AndreiasM5/IVA_DECK/README.md

<div align="center">

# IVA DECK

### A custom ESP32 macro keyboard with a desktop companion and behavioral recognition

**9 mechanical keys · 3 volume controls · LCD + microSD · USB / Bluetooth · Python + PyQt6**

[Download Windows app](https://github.com/AndreiasM5/IVA_DECK/releases/latest) · [Install V5](docs/windows-app-v5.ro.md) · [Demo](docs/media/iva-deck-demo.mp4) · [Get started](docs/getting-started.md) · [Hardware](docs/hardware.md) · [Protocol](docs/protocol.md) · [AI experiment](docs/behavioral-recognition.md) · [Română](docs/README.ro.md)

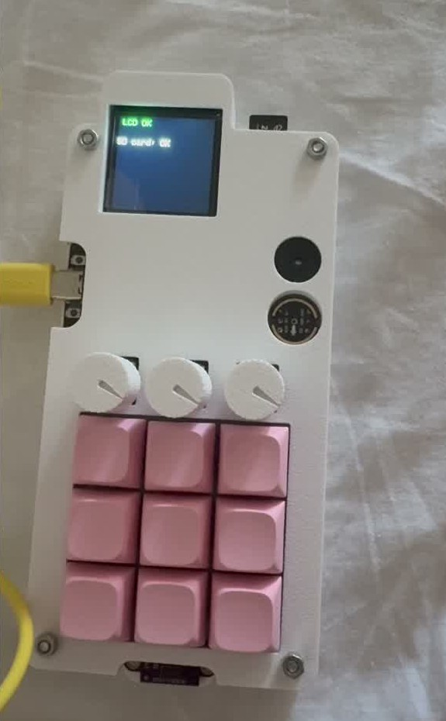
[picture p1: docs/media/iva-deck-device.jpg]
IVA DECK with nine pink keys, three knobs, sensors, and a color display


**Designed and built by Ioan-Andrei Ivașcu**

</div>

IVA DECK combines a custom PCB, ESP32 electronics, embedded software, a Windows desktop application, and a behavioral recognition experiment. Nine programmable keys handle shortcuts and media actions, three physical knobs control application volume, and the companion app exposes the display, storage, buzzer, and proximity sensor.

The original academic project was presented in June 2025 at the Faculty of Mathematics and Computer Science, University of Bucharest, as **“Tastatură Inteligentă cu Recunoaștere Comportamentală asistată de AI.”**

## Windows app — V5

**[Download the Windows installer](https://github.com/AndreiasM5/IVA_DECK/releases/latest)** · [Ghid de instalare în română](docs/windows-app-v5.ro.md) · [Source and build instructions](SOFTWARE/APP/v5/)

Install **IVA-DECK-5.0.0-Setup-x64.exe**, pair your deck over Bluetooth or connect USB, then select its port in **Conexiune**. No separate Python installation is needed. Supports Windows 10 21H2+ / Windows 11 x64.

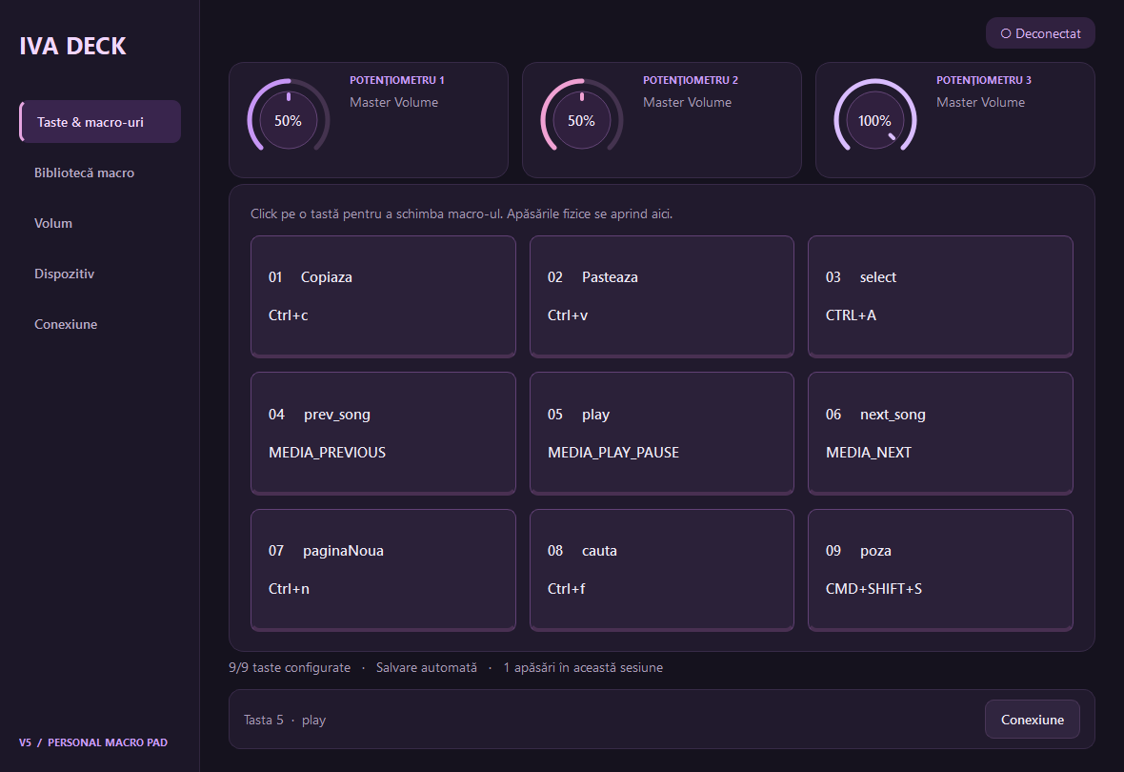
[picture p2: docs/media/app-v5-dashboard.png]
IVA DECK V5 dashboard


V5 adds a purple/pink interface, macro labels and assignment dialogs, an editable macro library and three animated potentiometers. The **Volum** page selects audio targets. Macros, audio targets and the last port are saved per user. AI and SD-image workflows are outside this release. V4 and the historical project documentation remain available.

The V5 application is free software under [GPLv3](SOFTWARE/APP/v5/LICENSE). This first installer is unsigned; see the release notes and SHA-256 checksums.

## See it working

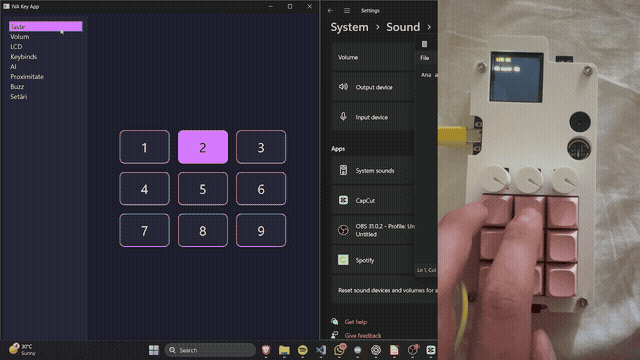
[picture p3: docs/media/demo-preview.gif]
Companion app and physical keyboard in action


**[Full demonstration with audio — 2 min 8 sec](docs/media/iva-deck-demo.mp4)**

The recording shows key presses, macro configuration, audio controls, proximity feedback, display interaction, and behavioral analysis. The GIF is a silent excerpt. Open or download the MP4 for the complete recording.

## What I built

| Layer | Contribution |
| --- | --- |
| Hardware | Custom KiCad PCBs, 3×3 key matrix, three potentiometers, peripheral integration, and enclosure |
| Embedded | ESP32 peripheral control and bidirectional serial messaging |
| Desktop | PyQt6 interface for macros, Windows volume control, device commands, and logging |
| AI experiment | Feature extraction and Random Forest recognition using keys, timing, distance, and volume |

## Desktop companion

| Live keys | Application volume |
| --- | --- |
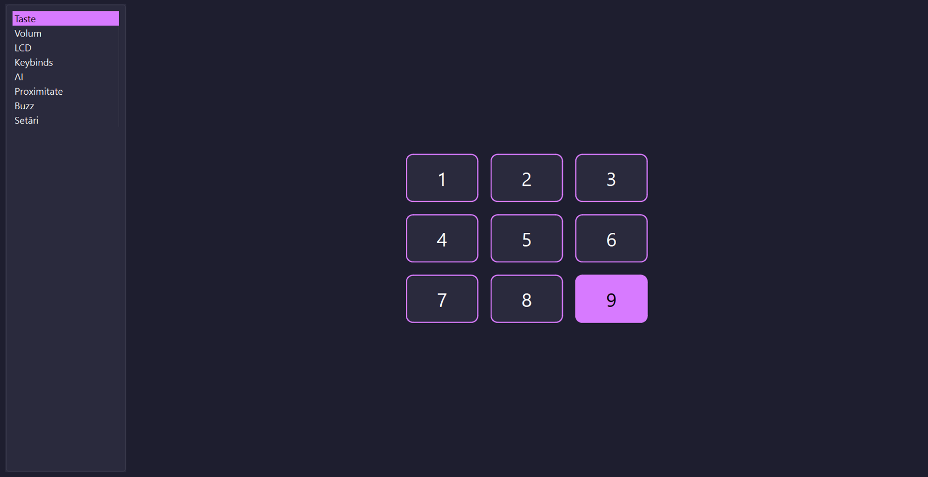
[picture p4: docs/media/app-keys.png]
Nine-key view
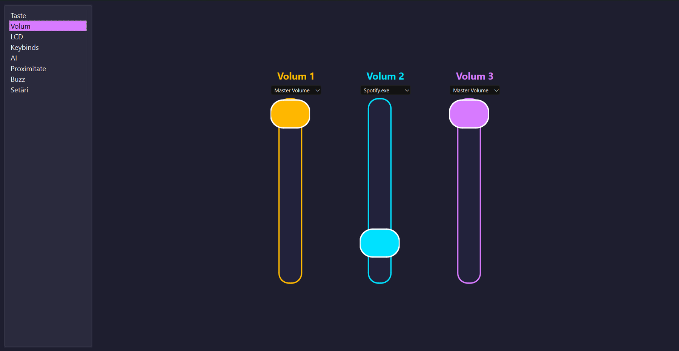
[picture p5: docs/media/app-volume.png]
Volume controls
|  |  |

| Macros | Display and storage |
| --- | --- |
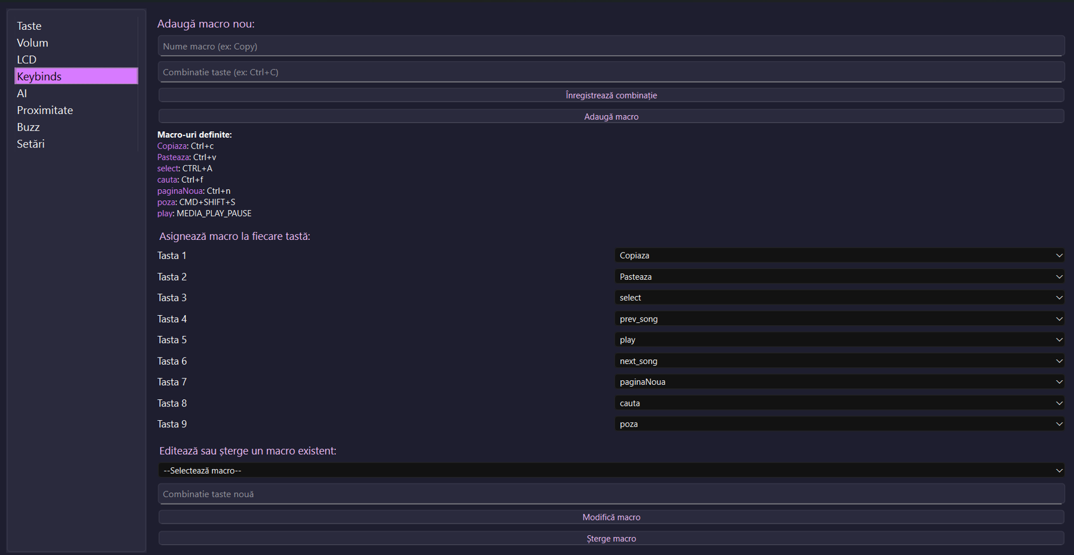
[picture p6: docs/media/app-macros.png]
Macro configuration
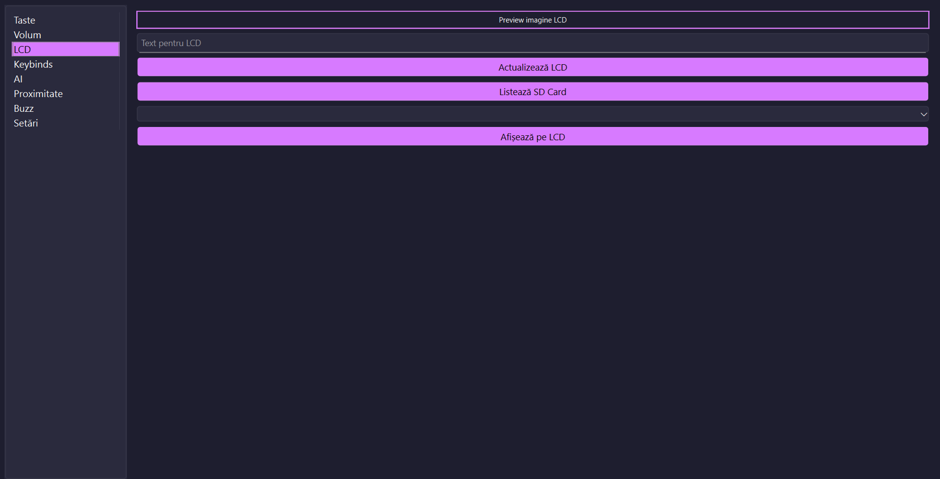
[picture p7: docs/media/app-display.png]
LCD interface
|  |  |

The application targets **Windows**, using `pycaw` and Windows COM APIs for audio-session control. Its interface is in Romanian.

<details>
<summary>More application screens: proximity and connections</summary>

| Proximity | Connection settings |
| --- | --- |
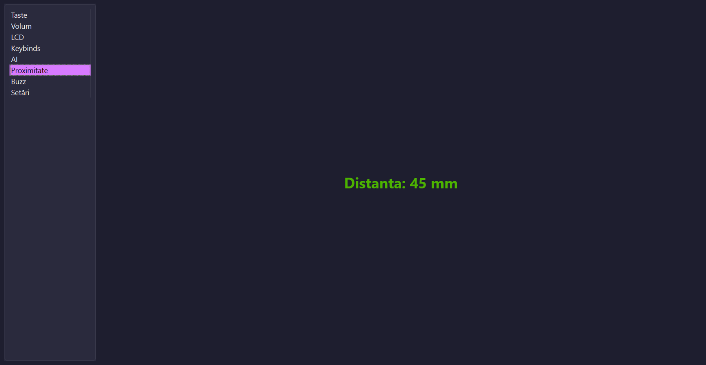
[picture p8: docs/media/app-proximity.png]
Live proximity feedback
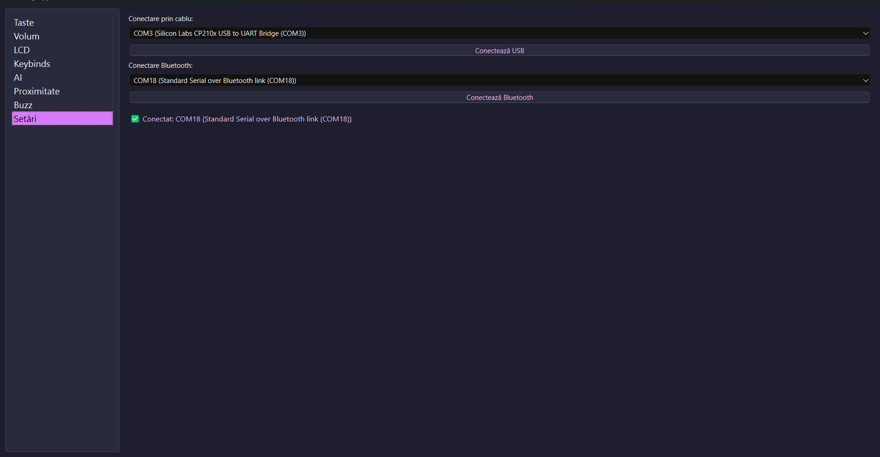
[picture p9: docs/media/app-settings.png]
USB and Bluetooth port selection
|  |  |

</details>

## Architecture

```mermaid
flowchart LR
  Keys[3x3 matrix] -->|GPIO| ESP[ESP32]
  Knobs[Three knobs] -->|ADC| ESP
  ToF[VL53L0X] -->|I2C| ESP
  ESP -->|SPI| LCD[ST7789]
  ESP <-->|SPI| SD[microSD]
  ESP --> Buzzer[Buzzer]
  ESP <-->|JSON over USB or Bluetooth serial| App[PyQt6 app]
  App --> Macros[OS macros]
  App --> Audio[Windows audio]
  App --> Logs[Local logs]
  Logs --> Features[Feature extraction]
  Features --> RF[Random Forest]
```

The INMP441 microphone is included in the hardware design. Full host audio streaming and voice control are unfinished, rather than demonstrated features.

## From prototype to PCB

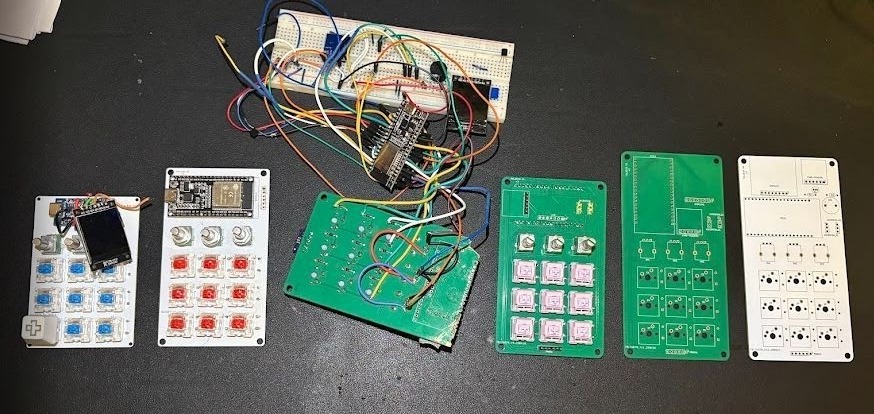
[picture p10: docs/media/hardware-evolution.jpg]
Successive boards and prototypes


| PCB layout | Enclosure design |
| --- | --- |
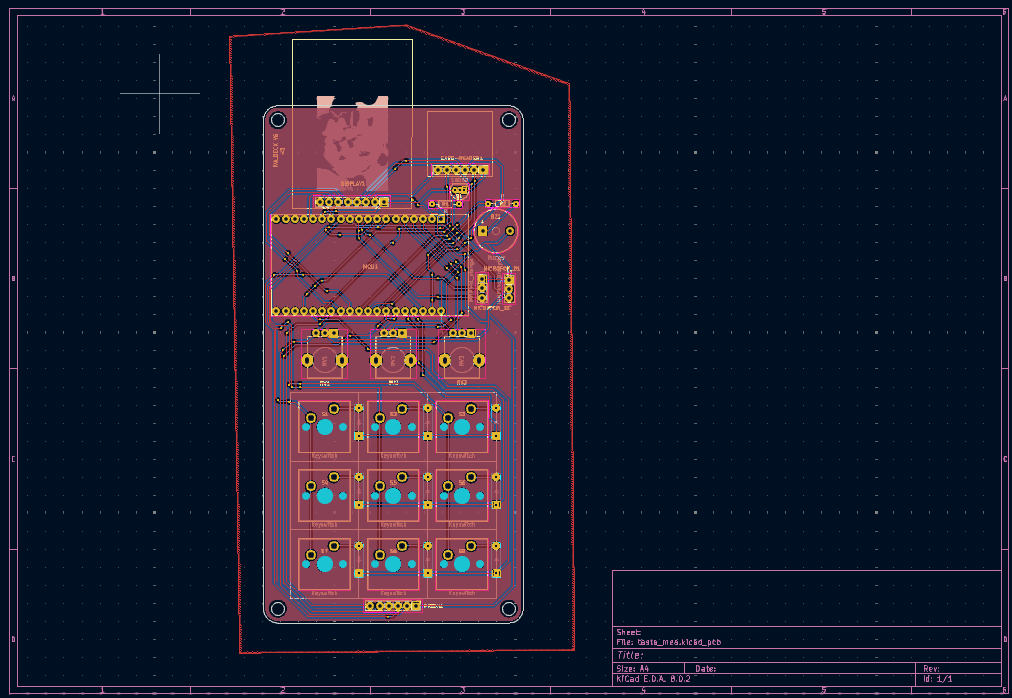
[picture p11: docs/media/pcb-layout.png]
KiCad layout
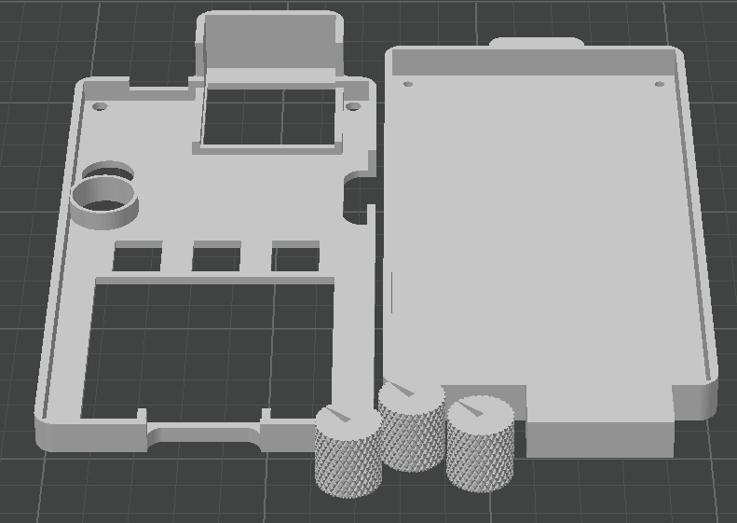
[picture p12: docs/media/enclosure-cad.png]
Enclosure CAD reference
|  |  |

Original hardware iterations are preserved. Start with [revision v6](HARDWARE/v6_esp32/) and the [hardware guide](docs/hardware.md).

## Explore

| Material | Contents |
| --- | --- |
| [Getting started](docs/getting-started.md) | Windows installation and connections |
| [Desktop source](SOFTWARE/APP/v4/iva_key_app/) | PyQt6 app and configuration |
| [ESP32 v6](SOFTWARE/DECK/v6_esp32/) | Sketches and firmware status |
| [KiCad hardware](HARDWARE/) | Schematics, layouts, and production exports |
| [Protocol](docs/protocol.md) | Host messages and commands |
| [Behavioral recognition](docs/behavioral-recognition.md) | Training workflow and evaluation limits |
| [Thesis](Documentation.pdf) | Original 52-page Romanian academic documentation |
| [Presentation PDF](docs/presentation-ro.pdf) | Romanian defense presentation |
| [Editable slides](Presentation.pptx) | Original slide deck |

## Project status

The desktop source, AI script, KiCad projects, and peripheral tests are available. A complete **historical ESP32 sketch was recovered from the author's development chat** and is included with provenance and compatibility notes. It has not been verified as the exact firmware used in the demo; see the [firmware status](SOFTWARE/DECK/v6_esp32/README.md).

The thesis reports approximately **70% behavioral recognition** in its experiment. This is a historical reported result, not a newly reproduced benchmark or an authentication guarantee. See the [AI guide](docs/behavioral-recognition.md).

Documentation and media were checked against the supplied materials and repository source. Fresh hardware operation, firmware compilation, and desktop integration have not been revalidated during this documentation update.

## Author

**Ioan-Andrei Ivașcu** · [@AndreiasM5](https://github.com/AndreiasM5)

Custom hardware, firmware development, companion software, and behavioral-recognition research for the original academic project.
