AndreiasM5/IVA_DECK/HARDWARE/README.md

# IVA DECK hardware

Start with [revision v6](v6_esp32/) and the [hardware guide](../docs/hardware.md).

Original directories preserve early Arduino Micro designs and later ESP32 iterations. Use editable KiCad sources for review; screenshots in `docs/media/` are explanatory references. Manufacturing exports have not been regenerated during this update.
