AndreiasM5/IVA_DECK/HARDWARE/v1..2_arduino_micro/production/bom.csv

Designator | Footprint | Quantity | Value | LCSC Part #
D1, D2, D3, D4, D5, D6, D7, D8, D9 | DO-35 | 9 | Diode
RV1, RV2, RV3 | Potentiometer_Runtron_RM-063_Horizontal | 3 | R_Potentiometer
S1, S2, S3, S4, S5, S6, S7, S8, S9 | MX_PCB_1.00u | 9 | Keyswitch
U1 | Arduino_Pro_Micro | 1 | Arduino_Pro_Micro
