AndreiasM5/IVA_DECK/HARDWARE/v5_esp32/tasta_mea.kicad_pcb

## KiCad design HARDWARE/v5_esp32/tasta_mea.kicad_pcb (2025-04-24, an earlier design)

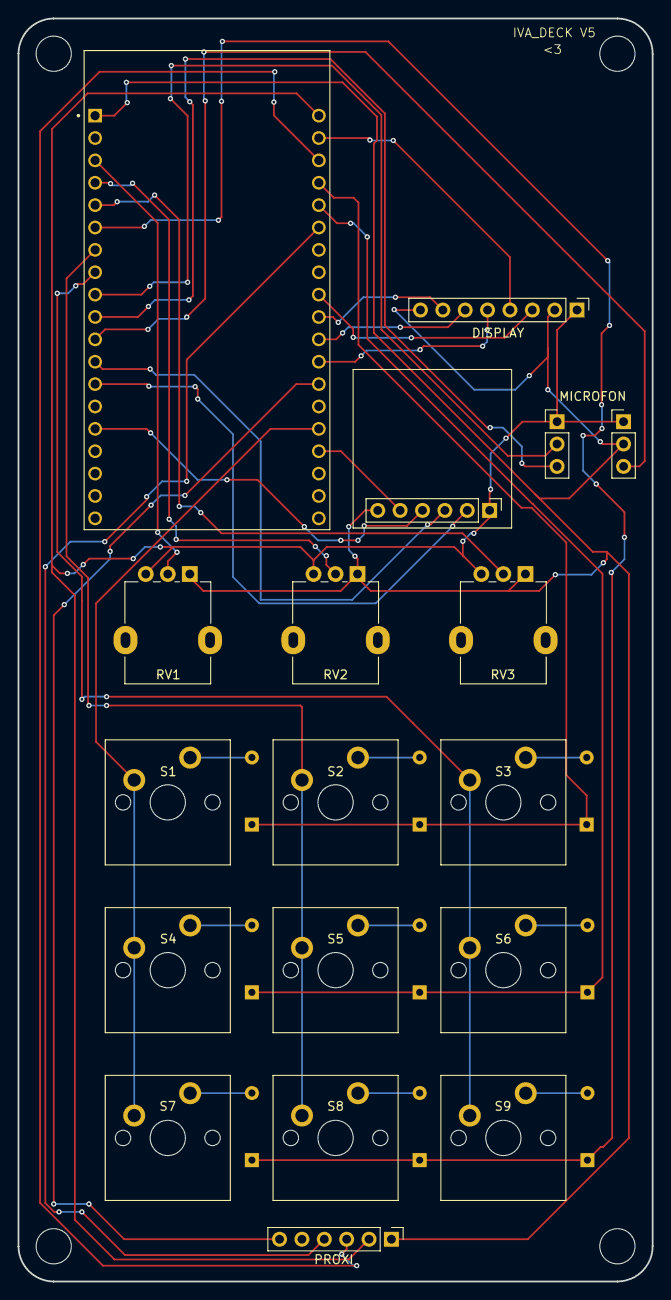
[picture p32: board tasta_mea.kicad_pcb from above]

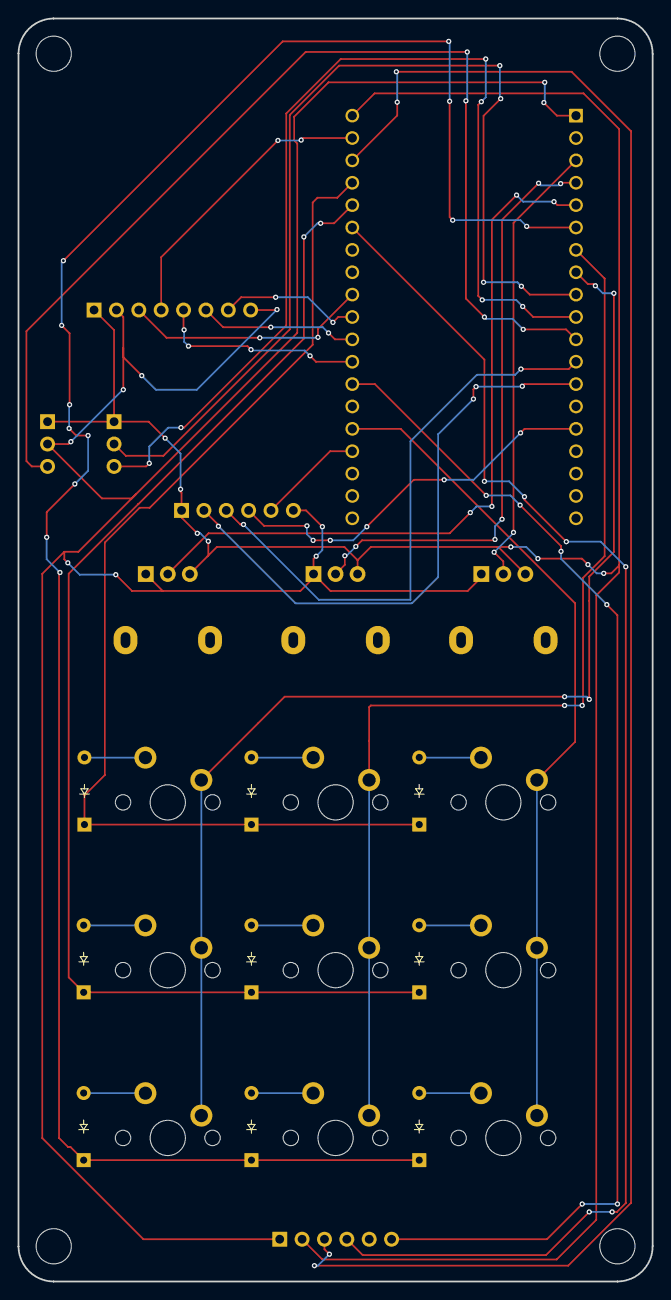
[picture p33: board tasta_mea.kicad_pcb from below]

Board: 2 copper layers, 72.0 x 143.4 mm, 27 parts (9 on the bottom side), 35 nets.

Parts:
D1, D2, D3, D4, D5, D6, D7, D8, D9: Diode; DO-35
DISPLAY: ST7789; PinHeader_1x08_P2.54mm_Vertical
J2: Card_reader; PinHeader_1x06_P2.54mm_Vertical
J4: IMNP441_Dreapta; PinHeader_1x03_P2.54mm_Vertical
MICROFON: IMNP441_stanga; PinHeader_1x03_P2.54mm_Vertical
PROXI: VL53L0X; PinHeader_1x06_P2.54mm_Vertical
RV1, RV2, RV3: R_Potentiometer; Potentiometer_Alpha_RD901F-40-00D_Single_Vertical
S1, S2, S3, S4, S5, S6, S7, S8, S9: Keyswitch; MX_PCB_1.00u
U3: ESP32-DEVKITC-32D; MODULE_ESP32-DEVKITC-32D

Connections:
C_clk: J2.3, U3.J2-12 (IO14)
C_cs: J2.5, U3.J3-16 (IO15)
C_gnd: DISPLAY.1, J2.1, J4.1, MICROFON.1, PROXI.2, RV1.3, RV2.3, RV3.3, U3.J3-1 (GND3)
C_miso: J2.2, U3.J2-13 (IO12)
C_mosi: J2.4, U3.J2-15 (IO13)
C_vcc: DISPLAY.2, DISPLAY.8, J2.6, J4.2, PROXI.1, RV1.1, RV2.1, RV3.1, U3.J2-1 (3V3)
D_CS: DISPLAY.7, U3.J3-10 (IO5)
D_DC: DISPLAY.6, U3.J3-11 (IO17)
D_RST: DISPLAY.5, U3.J3-12 (IO16)
D_SCL: DISPLAY.3, U3.J3-9 (IO18)
D_SDA: DISPLAY.4, U3.J3-2 (IO23)
M_SCK: MICROFON.3, U3.J2-10 (IO26)
M_SD: J4.3, U3.J2-11 (IO27)
M_WS: MICROFON.2, U3.J2-9 (IO25)
unnamed: D1.2 (A), S1.2
unnamed: D2.2 (A), S2.2
unnamed: D3.2 (A), S3.2
unnamed: D4.2 (A), S4.2
unnamed: D5.2 (A), S5.2
unnamed: D6.2 (A), S6.2
unnamed: D7.2 (A), S7.2
unnamed: D8.2 (A), S8.2
unnamed: D9.2 (A), S9.2
P_SCL: PROXI.3, U3.J3-3 (IO22)
P_SDA: PROXI.4, U3.J3-6 (IO21)
P_XSHUT: PROXI.6, U3.J3-13 (IO4)
col 1: S1.1, S4.1, S7.1, U3.J3-15 (IO2)
col 2: S2.1, S5.1, S8.1, U3.J2-7 (IO32)
col 3: S3.1, S6.1, S9.1, U3.J2-8 (IO33)
row 1: D1.1 (K), D2.1 (K), D3.1 (K), U3.J3-4 (TXD0)
row 2: D4.1 (K), D5.1 (K), D6.1 (K), U3.J3-5 (RXD0)
row 3: D7.1 (K), D8.1 (K), D9.1 (K), U3.J2-6 (IO35)
vol 1: RV1.2, U3.J2-3 (SENSOR_VP)
vol 2: RV2.2, U3.J2-4 (SENSOR_VN)
vol 3: RV3.2, U3.J2-5 (IO34)
