AndreiasM5/IVA_DECK/(commit log)

2025-03-27 hardware deck v1_arduino_micro
    [bom.csv, designators.csv, positions.csv, tasta_mea.csv, tasta_mea.kicad_pcb, tasta_mea.kicad_sch]
2025-03-27 hardware deck v1.2_arduino_micro
    [bom.csv, designators.csv, positions.csv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]
2025-03-27 hardware deck v2_esp32
    [bom.csv, designators.csv, positions.csv, tasta_mea.csv, tasta_mea.kicad_pcb, tasta_mea.kicad_sch]
2025-03-27 matix and volume test for esp32
2025-03-27 lcd test for esp32
2025-04-09 hardware deck v4_esp32
    [bom.csv, designators.csv, positions.csv, tasta_mea.csv, tasta_mea.kicad_pcb, tasta_mea.kicad_sch]
2025-04-24 hardware deck v5_esp32
    [bom.csv, designators.csv, positions.csv, tasta_mea.csv, tasta_mea.kicad_pcb, tasta_mea.kicad_sch]
2025-06-12 hardware deck v6_esp32
    [bom.csv, designators.csv, positions.csv, tasta_mea.csv, tasta_mea.kicad_sch]
